GliderWinchItems/drum/docs/datasheets/Digital Stepper Driver Y Series Digital Stepper Driver_files/DM860Y%201-600x600.jpg

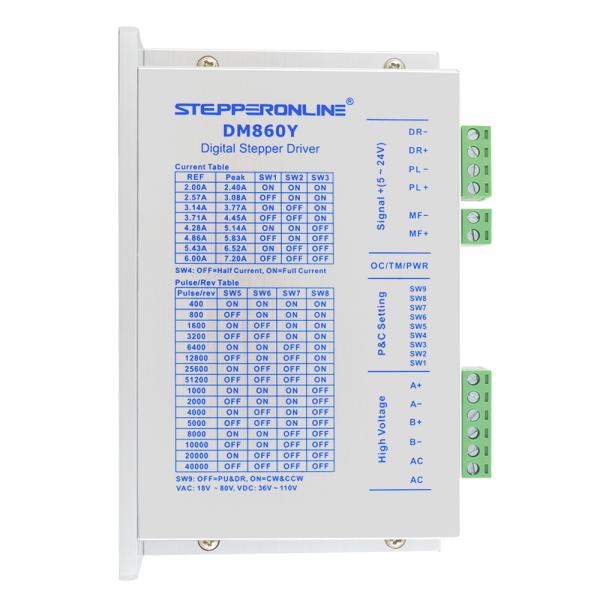
docs/datasheets/Digital Stepper Driver Y Series Digital Stepper Driver_files/DM860Y%201-600x600.jpg
