GliderWinchItems/drum/README.md

stepper

A hack of the GEVCUr repo (used for motor/dmoc testing) to test the stepper motor to be used for the winch level wind mechanism.
