GliderWinchItems/drum/drum.pdf

21/02/2025

drum Project
Configuration Report

## 1. Description

### 1.1. Project

Project Name | drum
Board Name | custom
Generated with: | STM32CubeMX 6.12.1
Date | 02/21/2025

### 1.2. MCU

MCU Series | STM32F4
MCU Line | STM32F407/417
MCU name | STM32F407VGTx
MCU Package | LQFP100
MCU Pin number | 100

### 1.3. Core(s) information

Core(s) | Arm Cortex-M4

## 2. Pinout Configuration

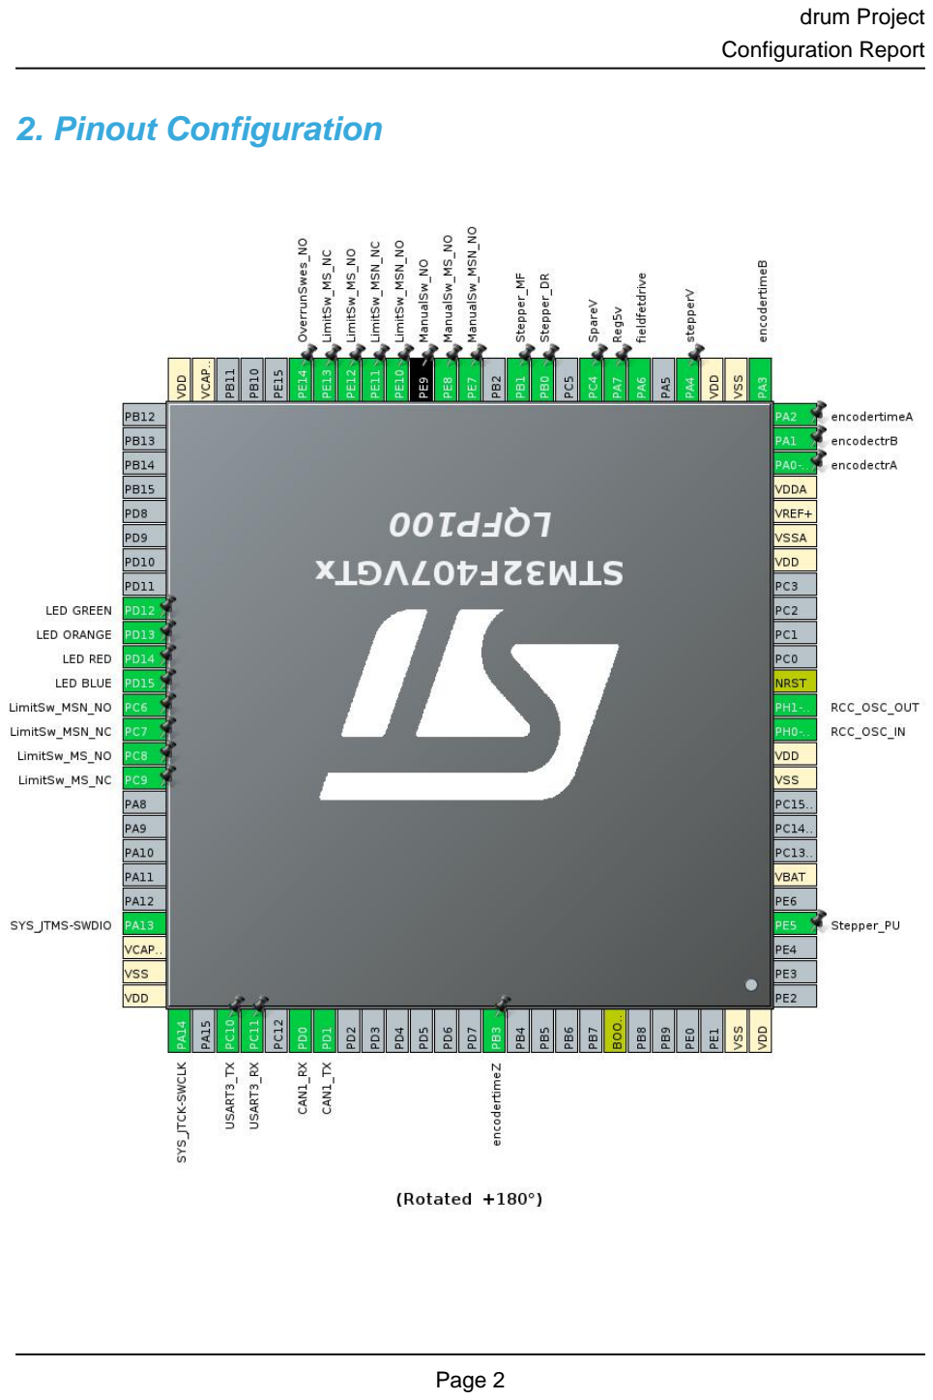
[picture p8: page 3]

## 3. Pins Configuration

Pin Number LQFP100 | Pin Name (function after reset) | Pin Type | Alternate Function(s) | Label
4 | PE5 | I/O | TIM9_CH1 | Stepper_PU
6 | VBAT | Power
10 | VSS | Power
11 | VDD | Power
12 | PH0-OSC_IN | I/O | RCC_OSC_IN
13 | PH1-OSC_OUT | I/O | RCC_OSC_OUT
14 | NRST | Reset
19 | VDD | Power
20 | VSSA | Power
21 | VREF+ | Power
22 | VDDA | Power
23 | PA0-WKUP | I/O | TIM5_CH1 | encodectrA
24 | PA1 | I/O | TIM5_CH2 | encodectrB
25 | PA2 | I/O | TIM2_CH3 | encodertimeA
26 | PA3 | I/O | TIM2_CH4 | encodertimeB
27 | VSS | Power
28 | VDD | Power
29 | PA4 | I/O | ADC1_IN4 | stepperV
31 | PA6 | I/O | TIM13_CH1 | fieldfetdrive
32 | PA7 | I/O | ADC1_IN7 | Reg5v
33 | PC4 | I/O | ADC1_IN14 | SpareV
35 | PB0 * | I/O | GPIO_Output | Stepper_DR
36 | PB1 * | I/O | GPIO_Output | Stepper_MF
38 | PE7 * | I/O | GPIO_Input | ManualSw_MSN_NO
39 | PE8 * | I/O | GPIO_Input | ManualSw_MS_NO
40 | PE9 * | I/O | GPIO_Input | ManualSw_NO
41 | PE10 | I/O | GPIO_EXTI10 | LimitSw_MSN_NO
42 | PE11 | I/O | GPIO_EXTI11 | LimitSw_MSN_NC
43 | PE12 | I/O | GPIO_EXTI12 | LimitSw_MS_NO
44 | PE13 | I/O | GPIO_EXTI13 | LimitSw_MS_NC
45 | PE14 * | I/O | GPIO_Input | OverrunSwes_NO
49 | VCAP_1 | Power
50 | VDD | Power
59 | PD12 * | I/O | GPIO_Output | LED GREEN
60 | PD13 * | I/O | GPIO_Output | LED ORANGE
61 | PD14 * | I/O | GPIO_Output | LED RED

Pin Number LQFP100 | Pin Name (function after reset) | Pin Type | Alternate Function(s) | Label
62 | PD15 * | I/O | GPIO_Output | LED BLUE
63 | PC6 | I/O | TIM3_CH1 | LimitSw_MSN_NO
64 | PC7 | I/O | TIM3_CH2 | LimitSw_MSN_NC
65 | PC8 | I/O | TIM3_CH3 | LimitSw_MS_NO
66 | PC9 | I/O | TIM3_CH4 | LimitSw_MS_NC
72 | PA13 | I/O | SYS_JTMS-SWDIO
73 | VCAP_2 | Power
74 | VSS | Power
75 | VDD | Power
76 | PA14 | I/O | SYS_JTCK-SWCLK
78 | PC10 | I/O | USART3_TX
79 | PC11 | I/O | USART3_RX
81 | PD0 | I/O | CAN1_RX
82 | PD1 | I/O | CAN1_TX
89 | PB3 | I/O | TIM2_CH2 | encodertimeZ
94 | BOOT0 | Boot
99 | VSS | Power
100 | VDD | Power

* The pin is affected with an I/O function

## 4. Clock Tree Configuration

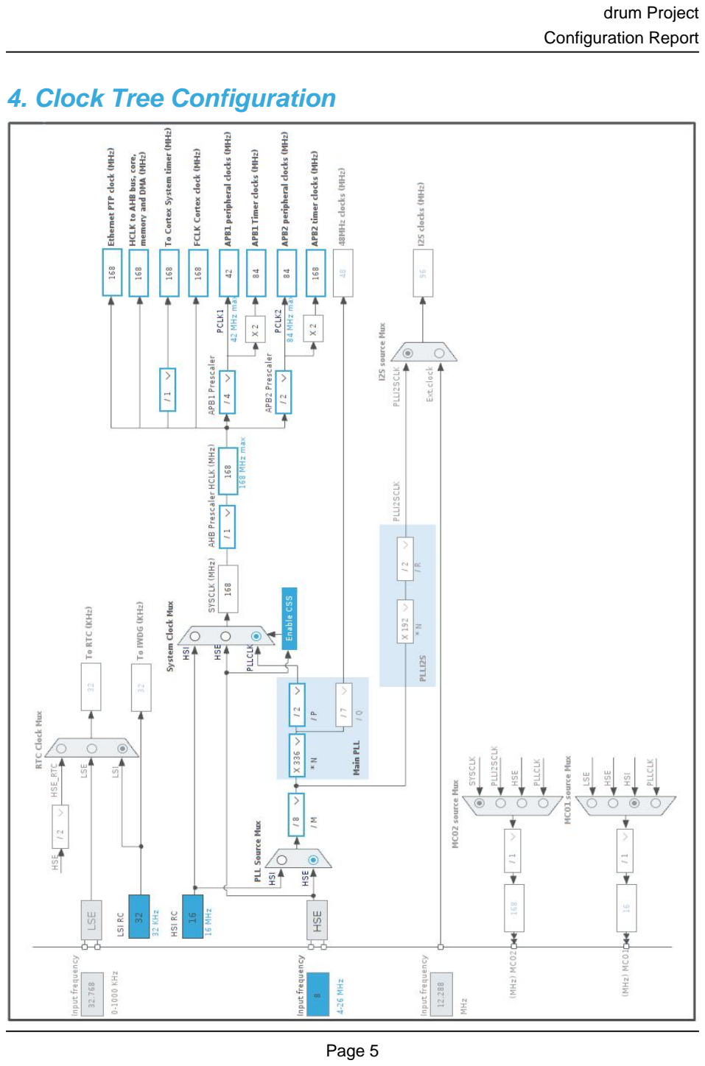
[picture p9: page 6]

## 1. Power Consumption Calculator report

### 1.1. Microcontroller Selection

Series | STM32F4
Line | STM32F407/417
MCU | STM32F407VGTx
Datasheet | DS8626_Rev8

### 1.2. Parameter Selection

Temperature | 25
Vdd | 3.3

### 1.3. Battery Selection

Battery | Li-SOCL2(A3400)
Capacity | 3400.0 mAh
Self Discharge | 0.08 %/month
Nominal Voltage | 3.6 V
Max Cont Current | 100.0 mA
Max Pulse Current | 200.0 mA
Cells in series | 1
Cells in parallel | 1

### 1.4. Sequence

Step | Step1 | Step2
Mode | RUN | STOP
Vdd | 3.3 | 3.3
Voltage Source | Battery | Battery
Range | Scale1-High | No Scale
Fetch Type | FLASH | n/a
CPU Frequency | 168 MHz | 0 Hz
Clock Configuration | HSE PLL | Regulator_LP Flash-PwrDwn
Clock Source Frequency | 4 MHz | 0 Hz
Peripherals
Additional Cons. | 0 mA | 0 mA
Average Current | 46 mA | 280 µA
Duration | 0.1 ms | 0.9 ms
DMIPS | 210.0 | 0.0
Ta Max | 98.47 | 104.96
Category | In DS Table | In DS Table

### 1.5. Results

Sequence Time | 1 ms | Average Current | 4.85 mA
Battery Life | 29 days, 4 hours | Average DMIPS | 210.0 DMIPS

### 1.6. Chart

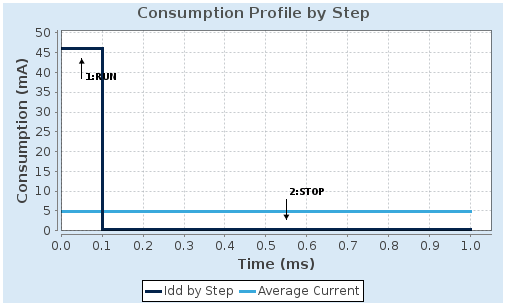
[picture p10: figure]

## 2. Software Project

### 2.1. Project Settings

Name | Value
Project Name | drum
Project Folder | /media/deh/fc65a06a-0110-42ac-85a6-
Toolchain / IDE | Makefile
Firmware Package Name and Version | STM32Cube FW_F4 V1.28.1
Application Structure | Basic
Generate Under Root | No
Do not generate the main() | No
Minimum Heap Size | 0x200
Minimum Stack Size | 0x400

### 2.2. Code Generation Settings

Name | Value
STM32Cube MCU packages and embedded software | Copy all used libraries into the project folder
Generate peripheral initialization as a pair of '.c/.h' files | No
Backup previously generated files when re-generating | No
Keep User Code when re-generating | Yes
Delete previously generated files when not re-generated | Yes
Set all free pins as analog (to optimize the power consumption) | No
Enable Full Assert | No

### 2.3. Advanced Settings - Generated Function Calls

Rank | Function Name | Peripheral Instance Name
1 | MX_GPIO_Init | GPIO
2 | MX_DMA_Init | DMA
3 | SystemClock_Config | RCC
4 | MX_CAN1_Init | CAN1
5 | MX_USART3_UART_Init | USART3
6 | MX_TIM2_Init | TIM2
7 | MX_TIM5_Init | TIM5
8 | MX_TIM9_Init | TIM9
9 | MX_TIM13_Init | TIM13
10 | MX_TIM3_Init | TIM3
11 | MX_ADC1_Init | ADC1

Rank | Function Name | Peripheral Instance Name
12 | MX_TIM4_Init | TIM4

## 3. Peripherals and Middlewares Configuration

### 3.1. ADC1

mode: IN4
mode: IN7
mode: IN14
mode: Temperature Sensor Channel mode: Vrefint Channel
3.1.1. Parameter Settings:

ADCs_Common_Settings:

Mode | Independent mode
ADC_Settings:
Clock Prescaler | PCLK2 divided by 4
Resolution | 12 bits (15 ADC Clock cycles)
Data Alignment | Right alignment
Scan Conversion Mode | Enabled
Continuous Conversion Mode | Enabled *
Discontinuous Conversion Mode | Disabled
DMA Continuous Requests | Enabled *
End Of Conversion Selection | EOC flag at the end of single channel conversion
ADC_Regular_ConversionMode:
Number Of Conversion | 5 *
External Trigger Conversion Source | Regular Conversion launched by software
External Trigger Conversion Edge | None
Rank | 1
Channel | Channel 4
Sampling Time | 480 Cycles *
Rank | 2 *
Channel | Channel 7 *
Sampling Time | 480 Cycles *
Rank | 3 *
Channel | Channel 14 *
Sampling Time | 480 Cycles *
Rank | 4 *
Channel | Channel Temperature Sensor *
Sampling Time | 480 Cycles *
Rank | 5 *

Channel | Channel Vrefint *
Sampling Time | 480 Cycles *
ADC_Injected_ConversionMode:
Number Of Conversions | 0
WatchDog:
Enable Analog WatchDog Mode | false

### 3.2. CAN1

mode: Activated
3.2.1. Parameter Settings:

Bit Timings Parameters:

Prescaler (for Time Quantum) | 12 *
Time Quantum | 285.7142857142857 *
Time Quanta in Bit Segment 1 | 5 Times *
Time Quanta in Bit Segment 2 | 1 Time
Time for one Bit | 2000 *
Baud Rate | 500000 *
ReSynchronization Jump Width | 1 Time
Basic Parameters:
Time Triggered Communication Mode | Disable
Automatic Bus-Off Management | Disable
Automatic Wake-Up Mode | Disable
Automatic Retransmission | Disable
Receive Fifo Locked Mode | Disable
Transmit Fifo Priority | Disable
Advanced Parameters:
Operating Mode | Normal

### 3.3. RCC

High Speed Clock (HSE): Crystal/Ceramic Resonator
3.3.1. Parameter Settings:

System Parameters:

VDD voltage (V) | 3.3
Instruction Cache | Enabled

Prefetch Buffer | Enabled
Data Cache | Enabled
Flash Latency(WS) | 5 WS (6 CPU cycle)
RCC Parameters:
HSI Calibration Value | 16
HSE Startup Timout Value (ms) | 100
LSE Startup Timout Value (ms) | 5000
Power Parameters:
Power Regulator Voltage Scale | Power Regulator Voltage Scale 1

### 3.4. SYS

Debug: Serial Wire
Timebase Source: TIM12

### 3.5. TIM2

Channel1: Output Compare No Output Channel2: Input Capture direct mode Channel3: Input Capture direct mode Channel4: Input Capture direct mode
3.5.1. Parameter Settings:

Counter Settings:

Prescaler (PSC - 16 bits value) | 0
Counter Mode | Up
Counter Period (AutoReload Register - 32 bits value ) | 4294967295
Internal Clock Division (CKD) | No Division
auto-reload preload | Disable
Trigger Output (TRGO) Parameters:
Master/Slave Mode (MSM bit) | Disable (Trigger input effect not delayed)
Trigger Event Selection | Reset (UG bit from TIMx_EGR)
Output Compare No Output Channel 1:
Mode | Frozen (used for Timing base)
Pulse (32 bits value) | 0
Output compare preload | Disable
CH Polarity | High
Input Capture Channel 2:
Polarity Selection | Both Edges *
IC Selection | Direct

Prescaler Division Ratio | No division
Input Filter (4 bits value) | 0
Input Capture Channel 3:
Polarity Selection | Both Edges *
IC Selection | Direct
Prescaler Division Ratio | No division
Input Filter (4 bits value) | 0
Input Capture Channel 4:
Polarity Selection | Both Edges *
IC Selection | Direct
Prescaler Division Ratio | No division
Input Filter (4 bits value) | 0

### 3.6. TIM3

Clock Source : Internal Clock Channel1: Input Capture direct mode Channel2: Input Capture direct mode Channel3: Input Capture direct mode Channel4: Input Capture direct mode
3.6.1. Parameter Settings:

Counter Settings:

Prescaler (PSC - 16 bits value) | 0
Counter Mode | Up
Counter Period (AutoReload Register - 16 bits value ) | 65535
Internal Clock Division (CKD) | No Division
auto-reload preload | Disable
Trigger Output (TRGO) Parameters:
Master/Slave Mode (MSM bit) | Disable (Trigger input effect not delayed)
Trigger Event Selection | Reset (UG bit from TIMx_EGR)
Input Capture Channel 1:
Polarity Selection | Falling Edge *
IC Selection | Direct
Prescaler Division Ratio | No division
Input Filter (4 bits value) | 15 *
Input Capture Channel 2:
Polarity Selection | Falling Edge *
IC Selection | Direct

Prescaler Division Ratio | No division
Input Filter (4 bits value) | 15 *
Input Capture Channel 3:
Polarity Selection | Falling Edge *
IC Selection | Direct
Prescaler Division Ratio | No division
Input Filter (4 bits value) | 15 *
Input Capture Channel 4:
Polarity Selection | Falling Edge *
IC Selection | Direct
Prescaler Division Ratio | No division
Input Filter (4 bits value) | 15 *

### 3.7. TIM4

Clock Source : Internal Clock Channel1: Output Compare No Output
3.7.1. Parameter Settings:

Counter Settings:

Prescaler (PSC - 16 bits value) | 13125 *
Counter Mode | Up
Counter Period (AutoReload Register - 16 bits value ) | 65535
Internal Clock Division (CKD) | No Division
auto-reload preload | Disable
Trigger Output (TRGO) Parameters:
Master/Slave Mode (MSM bit) | Disable (Trigger input effect not delayed)
Trigger Event Selection | Reset (UG bit from TIMx_EGR)
Output Compare No Output Channel 1:
Mode | Frozen (used for Timing base)
Pulse (16 bits value) | 0
Output compare preload | Disable
CH Polarity | High

### 3.8. TIM5

Combined Channels: Encoder Mode

3.8.1. Parameter Settings:

Counter Settings:

Prescaler (PSC - 16 bits value) | 0
Counter Mode | Up
Counter Period (AutoReload Register - 32 bits value ) | 4294967295
Internal Clock Division (CKD) | No Division
auto-reload preload | Disable
Trigger Output (TRGO) Parameters:
Master/Slave Mode (MSM bit) | Disable (Trigger input effect not delayed)
Trigger Event Selection | Reset (UG bit from TIMx_EGR)
Encoder:
Encoder Mode | Encoder Mode TI1
____ Parameters for Channel 1 ____
Polarity | Rising Edge
IC Selection | Direct
Prescaler Division Ratio | No division
Input Filter | 0
____ Parameters for Channel 2 ____
Polarity | Rising Edge
IC Selection | Direct
Prescaler Division Ratio | No division
Input Filter | 0

### 3.9. TIM9

mode: Clock Source
Channel1: PWM Generation CH1 mode: One Pulse Mode
3.9.1. Parameter Settings:

Counter Settings:

Prescaler (PSC - 16 bits value) | 0
Counter Mode | Up
Counter Period (AutoReload Register - 16 bits value ) | 1680 *
Internal Clock Division (CKD) | No Division
auto-reload preload | Disable
PWM Generation Channel 1:
Mode | PWM mode 1
Pulse (16 bits value) | 504 *

Output compare preload | Enable
Fast Mode | Disable
CH Polarity | High

### 3.10. TIM13

mode: Activated
Channel1: PWM Generation CH1
3.10.1. Parameter Settings:

Counter Settings:

Prescaler (PSC - 16 bits value) | 0
Counter Mode | Up
Counter Period (AutoReload Register - 16 bits value ) | 21000 *
Internal Clock Division (CKD) | No Division
auto-reload preload | Disable
PWM Generation Channel 1:
Mode | PWM mode 1
Pulse (16 bits value) | 0
Output compare preload | Enable
Fast Mode | Disable
CH Polarity | High

### 3.11. USART3

Mode: Asynchronous
3.11.1. Parameter Settings:

Basic Parameters:

Baud Rate | 115200
Word Length | 8 Bits (including Parity)
Parity | None
Stop Bits | 1
Advanced Parameters:
Data Direction | Receive and Transmit
Over Sampling | 16 Samples

### 3.12. FREERTOS

Interface: CMSIS_V1
3.12.1. Config parameters:

API:

FreeRTOS API | CMSIS v1
Versions:
FreeRTOS version | 10.3.1
CMSIS-RTOS version | 1.02
MPU/FPU:
ENABLE_MPU | Disabled
ENABLE_FPU | Disabled
Kernel settings:
USE_PREEMPTION | Enabled
CPU_CLOCK_HZ | SystemCoreClock
TICK_RATE_HZ | 512 *
MAX_PRIORITIES | 7
MINIMAL_STACK_SIZE | 96 *
MAX_TASK_NAME_LEN | 16
USE_16_BIT_TICKS | Disabled
IDLE_SHOULD_YIELD | Enabled
USE_MUTEXES | Enabled
USE_RECURSIVE_MUTEXES | Disabled
USE_COUNTING_SEMAPHORES | Disabled
QUEUE_REGISTRY_SIZE | 12 *
USE_APPLICATION_TASK_TAG | Disabled
ENABLE_BACKWARD_COMPATIBILITY | Enabled
USE_PORT_OPTIMISED_TASK_SELECTION | Enabled
USE_TICKLESS_IDLE | Disabled
USE_TASK_NOTIFICATIONS | Enabled
RECORD_STACK_HIGH_ADDRESS | Disabled
Memory management settings:
Memory Allocation | Dynamic / Static
TOTAL_HEAP_SIZE | 32768 *
Memory Management scheme | heap_4
Hook function related definitions:
USE_IDLE_HOOK | Disabled
USE_TICK_HOOK | Disabled
USE_MALLOC_FAILED_HOOK | Disabled
USE_DAEMON_TASK_STARTUP_HOOK | Disabled

CHECK_FOR_STACK_OVERFLOW | Option2 *
Run time and task stats gathering related definitions:
GENERATE_RUN_TIME_STATS | Disabled
USE_TRACE_FACILITY | Disabled
USE_STATS_FORMATTING_FUNCTIONS | Disabled
Co-routine related definitions:
USE_CO_ROUTINES | Disabled
MAX_CO_ROUTINE_PRIORITIES | 2
Software timer definitions:
USE_TIMERS | Enabled *
TIMER_TASK_PRIORITY | 2
TIMER_QUEUE_LENGTH | 10
TIMER_TASK_STACK_DEPTH | 192
Interrupt nesting behaviour configuration:
LIBRARY_LOWEST_INTERRUPT_PRIORITY | 15
LIBRARY_MAX_SYSCALL_INTERRUPT_PRIORITY | 5
Added with 10.2.1 support:
MESSAGE_BUFFER_LENGTH_TYPE | size_t
USE_POSIX_ERRNO | Disabled
3.12.2. Include parameters:

Include definitions:

vTaskPrioritySet | Enabled
uxTaskPriorityGet | Enabled
vTaskDelete | Disabled *
vTaskCleanUpResources | Disabled
vTaskSuspend | Enabled
vTaskDelayUntil | Enabled *
vTaskDelay | Enabled
xTaskGetSchedulerState | Enabled
xTaskResumeFromISR | Enabled
xQueueGetMutexHolder | Disabled
xSemaphoreGetMutexHolder | Disabled
pcTaskGetTaskName | Disabled
uxTaskGetStackHighWaterMark | Enabled *
xTaskGetCurrentTaskHandle | Enabled *
eTaskGetState | Disabled
xEventGroupSetBitFromISR | Disabled
xTimerPendFunctionCall | Disabled

xTaskAbortDelay | Disabled
xTaskGetHandle | Disabled
uxTaskGetStackHighWaterMark2 | Disabled
3.12.3. Advanced settings:

Newlib settings (see parameter description first):

USE_NEWLIB_REENTRANT | Disabled
Project settings (see parameter description first):
Use FW pack heap file | Enabled

* User modified value

## 4. System Configuration

### 4.1. GPIO configuration

IP | Pin | Signal | GPIO mode | GPIO pull/up pull down

Max
Speed

User Label

ADC1 | PA4 | ADC1_IN4 | Analog mode | No pull-up and no pull-down | n/a | stepperV
| PA7 | ADC1_IN7 | Analog mode | No pull-up and no pull-down | n/a | Reg5v
| PC4 | ADC1_IN14 | Analog mode | No pull-up and no pull-down | n/a | SpareV
CAN1 | PD0 | CAN1_RX | Alternate Function Push Pull | No pull-up and no pull-down | Very High
*
| PD1 | CAN1_TX | Alternate Function Push Pull | No pull-up and no pull-down | Very High
*
RCC | PH0- OSC_IN | RCC_OSC_IN | n/a | n/a | n/a
| PH1- OSC_OUT | RCC_OSC_OUT | n/a | n/a | n/a
SYS | PA13 | SYS_JTMS- SWDIO | n/a | n/a | n/a
| PA14 | SYS_JTCK- SWCLK | n/a | n/a | n/a
TIM2 | PA2 | TIM2_CH3 | Alternate Function
Open Drain *
| | | | No pull-up and no pull-down | Low | encodertimeA
| PA3 | TIM2_CH4 | Alternate Function
Open Drain *
| | | | No pull-up and no pull-down | Low | encodertimeB
| PB3 | TIM2_CH2 | Alternate Function
Open Drain *
| | | | No pull-up and no pull-down | Low | encodertimeZ
TIM3 | PC6 | TIM3_CH1 | Alternate Function Push Pull | Pull-up * | Low | LimitSw_MSN_NO
| PC7 | TIM3_CH2 | Alternate Function Push Pull | Pull-up * | Low | LimitSw_MSN_NC
| PC8 | TIM3_CH3 | Alternate Function Push Pull | Pull-up * | Low | LimitSw_MS_NO
| PC9 | TIM3_CH4 | Alternate Function Push Pull | Pull-up * | Low | LimitSw_MS_NC
TIM5 | PA0-WKUP | TIM5_CH1 | Alternate Function Push Pull | No pull-up and no pull-down | Low | encodectrA
| PA1 | TIM5_CH2 | Alternate Function Push Pull | No pull-up and no pull-down | Low | encodectrB
TIM9 | PE5 | TIM9_CH1 | Alternate Function Push Pull | Pull-up * | Very High
*
| | | | | | Stepper_PU
TIM13 | PA6 | TIM13_CH1 | Alternate Function Push Pull | No pull-up and no pull-down | Very High
*
| | | | | | fieldfetdrive
USART3 | PC10 | USART3_TX | Alternate Function Push Pull | No pull-up and no pull-down | Very High
*
| PC11 | USART3_RX | Alternate Function Push Pull | No pull-up and no pull-down | Very High

IP | Pin | Signal | GPIO mode | GPIO pull/up pull down | Max Speed | User Label
| | | | | *
GPIO | PB0 | GPIO_Output | Output Push Pull | No pull-up and no pull-down | Medium * | Stepper_DR
PB1 | GPIO_Output | Output Push Pull | No pull-up and no pull-down | Low | Stepper_MF
PE7 | GPIO_Input | Input mode | Pull-up * | n/a | ManualSw_MSN_NO
PE8 | GPIO_Input | Input mode | Pull-up * | n/a | ManualSw_MS_NO
PE9 | GPIO_Input | Input mode | Pull-up * | n/a | ManualSw_NO
PE10 | GPIO_EXTI10 | External Interrupt Mode with Falling edge trigger detection | Pull-up * | n/a | LimitSw_MSN_NO
PE11 | GPIO_EXTI11 | External Interrupt Mode with Falling edge trigger detection | Pull-up * | n/a | LimitSw_MSN_NC
PE12 | GPIO_EXTI12 | External Interrupt Mode with Falling edge trigger detection | Pull-up * | n/a | LimitSw_MS_NO
PE13 | GPIO_EXTI13 | External Interrupt Mode with Falling edge trigger detection | Pull-up * | n/a | LimitSw_MS_NC
PE14 | GPIO_Input | Input mode | Pull-up * | n/a | OverrunSwes_NO
PD12 | GPIO_Output | Output Push Pull | No pull-up and no pull-down | Low | LED GREEN
PD13 | GPIO_Output | Output Push Pull | No pull-up and no pull-down | Low | LED ORANGE
PD14 | GPIO_Output | Output Push Pull | No pull-up and no pull-down | Low | LED RED
PD15 | GPIO_Output | Output Push Pull | No pull-up and no pull-down | Low | LED BLUE

### 4.2. DMA configuration

DMA request | Stream | Direction | Priority
USART3_RX | DMA1_Stream1 | Peripheral To Memory | Low
USART3_TX | DMA1_Stream3 | Memory To Peripheral | Low
ADC1 | DMA2_Stream0 | Peripheral To Memory | Low

USART3_RX: DMA1_Stream1 DMA request Settings:

Mode: | Normal
Use fifo: | Disable
Peripheral Increment: | Disable
Memory Increment: | Enable *
Peripheral Data Width: | Byte
Memory Data Width: | Byte

USART3_TX: DMA1_Stream3 DMA request Settings:

Mode: | Normal
Use fifo: | Disable
Peripheral Increment: | Disable
Memory Increment: | Enable *
Peripheral Data Width: | Byte
Memory Data Width: | Byte

ADC1: DMA2_Stream0 DMA request Settings:

Mode: | Circular *
Use fifo: | Disable
Peripheral Increment: | Disable
Memory Increment: | Enable *
Peripheral Data Width: | Half Word
Memory Data Width: | Half Word

### 4.3. NVIC configuration

4.3.1. NVIC
Interrupt Table | Enable | Preenmption Priority | SubPriority
Non maskable interrupt | true | 0 | 0
Hard fault interrupt | true | 0 | 0
Memory management fault | true | 0 | 0
Pre-fetch fault, memory access fault | true | 0 | 0
Undefined instruction or illegal state | true | 0 | 0
System service call via SWI instruction | true | 0 | 0
Debug monitor | true | 0 | 0
Pendable request for system service | true | 15 | 0
System tick timer | true | 15 | 0
DMA1 stream1 global interrupt | true | 10 | 0
DMA1 stream3 global interrupt | true | 10 | 0
ADC1, ADC2 and ADC3 global interrupts | true | 7 | 0
CAN1 TX interrupts | true | 7 | 0
CAN1 RX0 interrupts | true | 7 | 0
CAN1 RX1 interrupt | true | 7 | 0
TIM1 break interrupt and TIM9 global interrupt | true | 6 | 0
TIM2 global interrupt | true | 2 | 0
TIM4 global interrupt | true | 2 | 0
USART3 global interrupt | true | 8 | 0
EXTI line[15:10] interrupts | true | 5 | 0
TIM8 break interrupt and TIM12 global interrupt | true | 0 | 0
DMA2 stream0 global interrupt | true | 7 | 0
PVD interrupt through EXTI line 16 | | unused
Flash global interrupt | | unused
RCC global interrupt | | unused
CAN1 SCE interrupt | | unused
TIM3 global interrupt | | unused
TIM8 update interrupt and TIM13 global interrupt | | unused
TIM5 global interrupt | | unused
FPU global interrupt | | unused
4.3.2. NVIC Code generation

Enabled interrupt Table Select for init
sequence ordering
| | Generate IRQ
| | handler | Call HAL handler
Non maskable interrupt | false | true | false
Hard fault interrupt | false | true | false

Enabled interrupt Table | Select for init sequence ordering | Generate IRQ handler | Call HAL handler
Memory management fault | false | true | false
Pre-fetch fault, memory access fault | false | true | false
Undefined instruction or illegal state | false | true | false
System service call via SWI instruction | false | false | false
Debug monitor | false | true | false
Pendable request for system service | false | false | false
System tick timer | false | false | true
DMA1 stream1 global interrupt | false | true | true
DMA1 stream3 global interrupt | false | true | true
ADC1, ADC2 and ADC3 global interrupts | false | true | true
CAN1 TX interrupts | false | true | true
CAN1 RX0 interrupts | false | true | true
CAN1 RX1 interrupt | false | true | true
TIM1 break interrupt and TIM9 global interrupt | false | true | true
TIM2 global interrupt | false | true | true
TIM4 global interrupt | false | true | true
USART3 global interrupt | false | true | true
EXTI line[15:10] interrupts | false | true | true
TIM8 break interrupt and TIM12 global interrupt | false | true | true
DMA2 stream0 global interrupt | false | true | true

* User modified value

## 5. System Views

5.1. Category view
5.1.1. Current

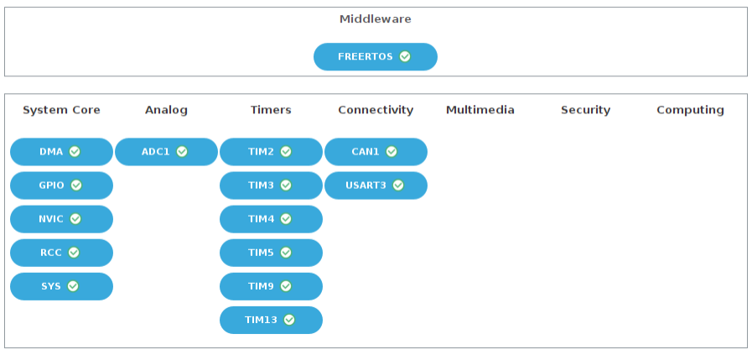
[picture p11: figure]

## 6. Docs & Resources

Type | Link
BSDL files | https://www.st.com/resource/en/bsdl_model/stm32f405-415_407-417_bsdl.zip
IBIS models | https://www.st.com/resource/en/ibis_model/stm32f405-415_407-417_ibis.zip
System View Description | https://www.st.com/resource/en/svd/stm32f4-svd.zip
Presentations | https://www.st.com/resource/en/product_presentation/stm32-stm8_embedded_software_solutions.pdf
Presentations | https://www.st.com/resource/en/product_presentation/stm32_eval-tools_portfolio.pdf
Presentations | https://www.st.com/resource/en/product_presentation/stm32_stm8_functi onal-safety-packages.pdf
Presentations | https://www.st.com/resource/en/product_presentation/stm32-stm8_software_development_tools.pdf
Presentations | https://www.st.com/resource/en/product_presentation/microcontrollers-stm32-family-overview.pdf
Presentations | https://www.st.com/resource/en/product_presentation/microcontrollers-stm32h7rs-lines-overview.pdf
Brochures | https://www.st.com/resource/en/brochure/products-and-solutions-for-plcs-and-smart-i-os.pdf
Flyers | https://www.st.com/resource/en/flyer/flstm32nucleo.pdf
Flyers | https://www.st.com/resource/en/flyer/flstmcsuite.pdf
Flyers | https://www.st.com/resource/en/flyer/flstm32trust.pdf
Product Certifications | https://www.st.com/resource/en/certification_document/stm32_authentication_can.pdf
Application Notes | https://www.st.com/resource/en/application_note/an1709-emc-design-guide-for-stm8-stm32-and-legacy-mcus-stmicroelectronics.pdf
Application Notes | https://www.st.com/resource/en/application_note/an2606-stm32-microcontroller-system-memory-boot-mode-stmicroelectronics.pdf

Application Notes | https://www.st.com/resource/en/application_note/an2639-soldering-recommendations-and-package-information-for-leadfree-ecopack-mcus-and-mpus-stmicroelectronics.pdf
Application Notes | https://www.st.com/resource/en/application_note/an2945-stm8s-and-stm32-mcus-a-consistent-832bit-product-line-for-painless-migration-stmicroelectronics.pdf
Application Notes | https://www.st.com/resource/en/application_note/an3070-managing-the-driver-enable-signal-for-rs485-and-iolink-communications-with-the-stm32s-usart-stmicroelectronics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
Application Notes | https://www.st.com/resource/en/application_note/an3126-audio-and-waveform-generation-using-the-dac-in-stm32-products-stmicroelectronics.pdf
Application Notes | https://www.st.com/resource/en/application_note/an3154-can-protocol-used-in-the-stm32-bootloader-stmicroelectronics.pdf
Application Notes | https://www.st.com/resource/en/application_note/an3155-usart-protocol-used-in-the-stm32-bootloader-stmicroelectronics.pdf
Application Notes | https://www.st.com/resource/en/application_note/an3156-usb-dfu-protocol-used-in-the-stm32-bootloader-stmicroelectronics.pdf
Application Notes | https://www.st.com/resource/en/application_note/an3364-migration-and-compatibility-guidelines-for-stm32-microcontroller-applications-stmicroelectronics.pdf
Application Notes | https://www.st.com/resource/en/application_note/an3371-using-the-hardware-realtime-clock-rtc-in-stm32-f0-f2-f3-f4-and-l1-series-of-mcus-stmicroelectronics.pdf
Application Notes | https://www.st.com/resource/en/application_note/an3997-audio-playback-and-recording-using-the-stm32f4discovery-stmicroelectronics.pdf
Application Notes | https://www.st.com/resource/en/application_note/an3998-pdm-audio-software-decoding-on-stm32-microcontrollers-stmicroelectronics.pdf
Application Notes | https://www.st.com/resource/en/application_note/an4031-using-the-stm32f2-stm32f4-and-stm32f7-series-dma-controller-stmicroelectronics.pdf
Application Notes | https://www.st.com/resource/en/application_note/an4073-how-to-improve-adc-accuracy-when-using-stm32f2xx-and-stm32f4xx-microcontrollers-stmicroelectronics.pdf

Application Notes | https://www.st.com/resource/en/application_note/an4076-two-or-three-shunt-resistor-based-current-sensing-circuit-design-in-3phase-inverters-stmicroelectronics.pdf
Application Notes | https://www.st.com/resource/en/application_note/an4221-i2c-protocol-used-in-the-stm32-bootloader-stmicroelectronics.pdf
Application Notes | https://www.st.com/resource/en/application_note/an4286-spi-protocol-used-in-the-stm32-bootloader-stmicroelectronics.pdf
Application Notes | https://www.st.com/resource/en/application_note/an4488-getting-started-with-stm32f4xxxx-mcu-hardware-development-stmicroelectronics.pdf
Application Notes | https://www.st.com/resource/en/application_note/an4547-migrating-from-stm32f407xx417xx-to-stm32f427xx429xx437xx439xx-stmicroelectronics.pdf
Application Notes | https://www.st.com/resource/en/application_note/an4566-extending-the-dac-performance-of-stm32-microcontrollers-stmicroelectronics.pdf
Application Notes | https://www.st.com/resource/en/application_note/an4640-peripherals-interconnections-on-stm32f4057xx-stm32f4157xx-stm32f42xxx-stm32f43xxx-stm32f446xx-and-stm32f469479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
Application Notes | https://www.st.com/resource/en/application_note/an4655-virtually-increasing-the-number-of-serial-communication-peripherals-in-stm32-applications-stmicroelectronics.p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
Application Notes | https://www.st.com/resource/en/application_note/an4739-stm32cube-firmware-examples-for-stm32f4-series-stmicroelectronics.pdf
Application Notes | https://www.st.com/resource/en/application_note/an4750-handling-of-soft-errors-in-stm32-applications-stmicroelectronics.pdf
Application Notes | https://www.st.com/resource/en/application_note/an4776-generalpurpose-timer-cookbook-for-stm32-microcontrollers-stmicroelectronics.pdf
Application Notes | https://www.st.com/resource/en/application_note/an4803-highspeed-si-simulations-using-ibis-and-boardlevel-simulations-using-hyperlynx-si-on-stm32-mcus-and-mpus-stmic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
Application Notes | https://www.st.com/resource/en/application_note/an4821-migrating-from-stm32f405415-line-and-stm32f407417-line-to-stm32l4-series-and-stm32l4-series-microcontrollers-s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
Application Notes | https://www.st.com/resource/en/application_note/an4850-stm32-mcus-

| spreadspectrum-clock-generation-principles-properties-and-implementation-stmicroelectronics.pdf
Application Notes | https://www.st.com/resource/en/application_note/an4989-stm32-microcontroller-debug-toolbox-stmicroelectronics.pdf
Application Notes | https://www.st.com/resource/en/application_note/an4995-using-an-electromyogram-technique-to-detect-muscle-activity-stmicroelectronics.pdf
Application Notes | https://www.st.com/resource/en/application_note/an5020-digital-camera-interface-dcmi-on-stm32-mcus-stmicroelectronics.pdf
Application Notes | https://www.st.com/resource/en/application_note/an5027-interfacing-pdm-digital-microphones-using-stm32-mcus-and-mpus-stmicroelectronics.pdf
Application Notes | https://www.st.com/resource/en/application_note/an5073-receiving-spdif-audio-stream-with-the-stm32f4f7h7-series-stmicroelectronics.pdf
Application Notes | https://www.st.com/resource/en/application_note/an4899-stm32-microcontroller-gpio-hardware-settings-and-lowpower-consumption-stmicroelectronics.pdf
Application Notes | https://www.st.com/resource/en/application_note/an5612-esd-protection-of-stm32-mcus-and-mpus-stmicroelectronics.pdf
Application Notes | https://www.st.com/resource/en/application_note/an4838-introduction-to-memory-protection-unit-management-on-stm32-mcus-stmicroelectronics.pdf
Application Notes | https://www.st.com/resource/en/application_note/an4879-introduction-to-usb-hardware-and-pcb-guidelines-using-stm32-mcus-stmicroelectronics.pdf
Application Notes | https://www.st.com/resource/en/application_note/an5225-introduction-to-usb-typec-power-delivery-for-stm32-mcus-and-mpus-stmicroelectronics.pdf
Application Notes | https://www.st.com/resource/en/application_note/an2834-how-to-optimize-the-adc-accuracy-in-the-stm32-mcus-stmicroelectronics.pdf
Application Notes | https://www.st.com/resource/en/application_note/an5537-how-to-use-adc-oversampling-techniques-to-improve-signaltonoise-ratio-on-stm32-mcus-stmicroelectronics.pdf
Application Notes | https://www.st.com/resource/en/application_note/an5036-guidelines-for-

| thermal-management-on-stm32-applications-stmicroelectronics.pdf
Application Notes | https://www.st.com/resource/en/application_note/an4230-introduction-to-random-number-generation-validation-using-the-nist-statistical-test-suite-for-stm32-mcus-and-m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
Application Notes | https://www.st.com/resource/en/application_note/an2867-guidelines-for-oscillator-design-on-stm8afals-and-stm32-mcusmpus-stmicroelectronics.pdf
Application Notes | https://www.st.com/resource/en/application_note/an4013-introduction-to-timers-for-stm32-mcus-stmicroelectronics.pdf
Application Notes | https://www.st.com/resource/en/application_note/an4277-how-to-use-pwm-shutdown-for-motor-control-and-digital-power-conversion-on-stm32-mcus-stmicroelectronics.pdf
Application Notes | https://www.st.com/resource/en/application_note/an4759-introduction-to-using-the-hardware-realtime-clock-rtc-and-the-tamper-management-unit-tamp-with-stm32-mcus-stmi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
Application Notes | https://www.st.com/resource/en/application_note/an4908-getting-started-with-usart-automatic-baud-rater-detection-for-stm32-mcus-stmicroelectronics.pdf
Application Notes | https://www.st.com/resource/en/application_note/an5156-introduction-to-security-for-stm32-mcus-stmicroelectronics.pdf
Application Notes | https://www.st.com/resource/en/application_note/an5543-guidelines-for-enhanced-spi-communication-on-stm32-mcus-and-mpus-stmicroelectronics.pdf
Application Notes for related Tools & Software | https://www.st.com/resource/en/application_note/an1202_freertos_guide-freertos-guide-stmicroelectronics.pdf
Application Notes for related Tools & Software | https://www.st.com/resource/en/application_note/an1602_semihosting_in_truestudio-how-to-do-semihosting-in-truestudio-stmicroelectronics.pdf
Application Notes for related Tools & Software | https://www.st.com/resource/en/application_note/an1801_stm32cubeprogrammer_in_truestudio-installing-stm32cubeprogrammer-in-truestudio-stmicroelectronics.pdf

Application Notes
for related Tools

https://www.st.com/resource/en/application_note/atollic_editing_keyboard_shortcuts-atollic-editing-keyboard-shortcuts-stmicroelectronics.pdf

& Software
Application Notes for related Tools & Software | https://www.st.com/resource/en/application_note/iar_to_atollic_truestudio_migration_guide-truestudio-for-arm-migration-guide-iar-embedded-workbench-to-truestudio-stm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
Application Notes for related Tools & Software | https://www.st.com/resource/en/application_note/stm32cubemx_installation_in_truestudio-stm32cubemx-installation-in-truestudio-stmicroelectronics.pdf
Application Notes for related Tools & Software | https://www.st.com/resource/en/application_note/an2656-stm32f10xxx-lcd-glass-driver-firmware-stmicroelectronics.pdf
Application Notes for related Tools & Software | https://www.st.com/resource/en/application_note/an2790-tft-lcd-interfacing-with-the-highdensity-stm32f10xxx-fsmc-stmicroelectronics.pdf
Application Notes for related Tools & Software | https://www.st.com/resource/en/application_note/an3078-stm32-inapplication-programming-over-the-ic-bus-stmicroelectronics.pdf
Application Notes for related Tools & Software | https://www.st.com/resource/en/application_note/an3116-stm32s-adc-modes-and-their-applications-stmicroelectronics.pdf
Application Notes for related Tools & Software | https://www.st.com/resource/en/application_note/an3174-implementing-receivers-for-infrared-remote-control-protocols-using-stm32f10xxx-microcontrollers-stmicroelectro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
Application Notes for related Tools & Software | https://www.st.com/resource/en/application_note/an3241-qvga-tftlcd-direct-drive-using-the-stm32f10xx-fsmc-peripheral-stmicroelectronics.pdf
Application Notes for related Tools & Software | https://www.st.com/resource/en/application_note/an3307-guidelines-for-obtaining-iec-60335-class-b-certification-for-any-stm32-application-stmicroelectronics.pdf
Application Notes for related Tools & Software | https://www.st.com/resource/en/application_note/an3364-migration-and-compatibility-guidelines-for-stm32-microcontroller-applications-stmicroelectronics.pdf
Application Notes for related Tools & Software | https://www.st.com/resource/en/application_note/an3965-stm32f40xstm32f41x-inapplication-programming-using-the-usart-stmicroelectronics.pdf

Application Notes for related Tools & Software | https://www.st.com/resource/en/application_note/an3966-lwip-tcpip-stack-demonstration-for-stm32f4x7-microcontrollers-stmicroelectronics.pdf
Application Notes for related Tools & Software | https://www.st.com/resource/en/application_note/an3968-stm32f407stm32f417-inapplication-programming-iap-over-ethernet-stmicroelectronics.pdf
Application Notes for related Tools & Software | https://www.st.com/resource/en/application_note/an3969-eeprom-emulation-in-stm32f40xstm32f41x-microcontrollers-stmicroelectronics.pdf
Application Notes for related Tools & Software | https://www.st.com/resource/en/application_note/an3988-clock-configuration-tool-for-stm32f40xx41xx427x437x-microcontrollers-stmicroelectronics.pdf
Application Notes for related Tools & Software | https://www.st.com/resource/en/application_note/an3990-upgrading-stm32f4discovery-board-firmware-using-a-usb-key-stmicroelectronics.pdf
Application Notes for related Tools & Software | https://www.st.com/resource/en/application_note/an3997-audio-playback-and-recording-using-the-stm32f4discovery-stmicroelectronics.pdf
Application Notes for related Tools & Software | https://www.st.com/resource/en/application_note/an3998-pdm-audio-software-decoding-on-stm32-microcontrollers-stmicroelectronics.pdf
Application Notes for related Tools & Software | https://www.st.com/resource/en/application_note/an4044-floating-point-unit-demonstration-on-stm32-microcontrollers-stmicroelectronics.pdf
Application Notes for related Tools & Software | https://www.st.com/resource/en/application_note/an4323-getting-started-with-stemwin-library-stmicroelectronics.pdf
Application Notes for related Tools & Software | https://www.st.com/resource/en/application_note/an4365-using-stm32f4-mcu-power-modes-with-best-dynamic-efficiency-stmicroelectronics.pdf
Application Notes for related Tools & Software | https://www.st.com/resource/en/application_note/an4435-guidelines-for-obtaining-ulcsaiec-607301603351-class-b-certification-in-any-stm32-application-stmicroelectroni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
Application Notes | https://www.st.com/resource/en/application_note/an4457-implementing-

for related Tools & Software | an-emulated-uart-on-stm32f4-microcontrollers-stmicroelectronics.pdf
Application Notes for related Tools & Software | https://www.st.com/resource/en/application_note/an4499-stm32--nrf51822-bluetooth-low-energy-system-solution-stmicroelectronics.pdf
Application Notes for related Tools & Software | https://www.st.com/resource/en/application_note/an4657-stm32-inapplication-programming-iap-using-the-usart-stmicroelectronics.pdf
Application Notes for related Tools & Software | https://www.st.com/resource/en/application_note/an4666-parallel-synchronous-transmission-using-gpio-and-dma-stmicroelectronics.pdf
Application Notes for related Tools & Software | https://www.st.com/resource/en/application_note/an4678-full-duplex-spi-emulation-for-stm32f4-microcontrollers-stmicroelectronics.pdf
Application Notes for related Tools & Software | https://www.st.com/resource/en/application_note/an4701-proprietary-code-readout-protection-on-microcontrollers-of-the-stm32f4-series-stmicroelectronics.pdf
Application Notes for related Tools & Software | https://www.st.com/resource/en/application_note/an4739-stm32cube-firmware-examples-for-stm32f4-series-stmicroelectronics.pdf
Application Notes for related Tools & Software | https://www.st.com/resource/en/application_note/an4758-proprietary-code-readout-protection-on-stm32l4-stm32l4-stm32g4-and-stm32wb-series-mcus-stmicroelectronics.pdf
Application Notes for related Tools & Software | https://www.st.com/resource/en/application_note/an4841-digital-signal-processing-for-stm32-microcontrollers-using-cmsis-stmicroelectronics.pdf
Application Notes for related Tools & Software | https://www.st.com/resource/en/application_note/an4968-proprietary-code-read-out-protection-pcrop-on-stm32f72xxx-and-stm32f73xxx-microcontrollers-stmicroelectronics.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
Application Notes for related Tools & Software | https://www.st.com/resource/en/application_note/an5056-integration-guide-for-the-xcubesbsfu-stm32cube-expansion-package-stmicroelectronics.pdf

Application Notes
for related Tools

https://www.st.com/resource/en/application_note/an5360-getting-startedwith-projects-based-on-the-stm32mp1-series-in-stm32cubeide-

& Software | stmicroelectronics.pdf
Application Notes for related Tools & Software | https://www.st.com/resource/en/application_note/an5361-getting-started-with-projects-based-on-dualcore-stm32h7-microcontrollers-in-stm32cubeide-stmicroelectronics.pd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
Application Notes for related Tools & Software | https://www.st.com/resource/en/application_note/an5394-getting-started-with-projects-based-on-the-stm32l5-series-in-stm32cubeide-stmicroelectronics.pdf
Application Notes for related Tools & Software | https://www.st.com/resource/en/application_note/an5418-how-to-build-a-simple-usbpd-sink-application-with-stm32cubemx-stmicroelectronics.pdf
Application Notes for related Tools & Software | https://www.st.com/resource/en/application_note/an5426-migrating-graphics-middleware-projects-from-stm32cubemx-540-to-stm32cubemx-550-stmicroelectronics.pdf
Application Notes for related Tools & Software | https://www.st.com/resource/en/application_note/an5464-position-control-of-a-threephase-permanent-magnet-motor-using-xcubemcsdk-or-xcubemcsdkful-stmicroelectronics.p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
Application Notes for related Tools & Software | https://www.st.com/resource/en/application_note/an5564-getting-started-with-projects-based-on-dualcore-stm32wl-microcontrollers-in-stm32cubeide-stmicroelectronics.pd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
Application Notes for related Tools & Software | https://www.st.com/resource/en/application_note/an5698-adapting-the-xcubestl-functional-safety-package-for-stm32-iec-61508-compliant-to-other-safety-standards-stmicr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
Application Notes for related Tools & Software | https://www.st.com/resource/en/application_note/an5731-stm32cubemx-and-stm32cubeide-threadsafe-solution-stmicroelectronics.pdf
Application Notes for related Tools & Software | https://www.st.com/resource/en/application_note/an4502-stm32-smbuspmbus-expansion-package-for-stm32cube-stmicroelectronics.pdf
Application Notes for related Tools & Software | https://www.st.com/resource/en/application_note/an5952-how-to-use-cmake-in-stm32cubeide-stmicroelectronics.pdf
Application Notes for related Tools & Software | https://www.st.com/resource/en/application_note/an5054-how-to-perform-secure-programming-using-stm32cubeprogrammer-stmicroelectronics.pdf

Errata Sheets | https://www.st.com/resource/en/errata_sheet/es0182-stm32f405407xx-and-stm32f415417xx-device-errata-stmicroelectronics.pdf
Datasheet | https://www.st.com/resource/en/datasheet/dm00037051.pdf
Programming Manuals | https://www.st.com/resource/en/programming_manual/pm0214-stm32-cortexm4-mcus-and-mpus-programming-manual-stmicroelectronics.pdf
Reference Manuals | https://www.st.com/resource/en/reference_manual/rm0090-stm32f405415-stm32f407417-stm32f427437-and-stm32f429439-advanced-armbased-32bit-mcus-stmicroelectronics.pdf
Technical Notes & Articles | https://www.st.com/resource/en/technical_note/tn0516-overview-of-the-stm32f0xf100xxf103xx-and-stm32f2xxf30xf4xx-mcus-pmsm-singledual-foc-sdk-v40-stmicroelectronics.p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
Technical Notes & Articles | https://www.st.com/resource/en/technical_note/tn1163-description-of-wlcsp-for-microcontrollers-and-recommendations-for-its-use-stmicroelectronics.pdf
Technical Notes & Articles | https://www.st.com/resource/en/technical_note/tn1204-tape-and-reel-shipping-media-for-stm32-microcontrollers-in-bga-packages-stmicroelectronics.pdf
Technical Notes & Articles | https://www.st.com/resource/en/technical_note/tn1205-tape-and-reel-shipping-media-for-stm8-and-stm32-microcontrollers-in-fpn-packages-stmicroelectronics.pdf
Technical Notes & Articles | https://www.st.com/resource/en/technical_note/tn1206-tape-and-reel-shipping-media-for-stm8-and-stm32-microcontrollers-in-qfp-packages-stmicroelectronics.pdf
Technical Notes & Articles | https://www.st.com/resource/en/technical_note/tn1207-tape-and-reel-shipping-media-for-stm8-and-stm32-microcontrollers-in-so-packages-stmicroelectronics.pdf
Technical Notes & Articles | https://www.st.com/resource/en/technical_note/tn1208-tape-and-reel-shipping-media-for-stm8-and-stm32-microcontrollers-in-tssop-and-ssop-packages-stmicroelectronics.p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
Technical Notes & Articles | https://www.st.com/resource/en/technical_note/tn1433-reference-device-marking-schematics-for-stm32-microcontrollers-and-microprocessors-stmicroelectronics.pdf

Technical Notes
& Articles

https://www.st.com/resource/en/technical_note/tn1489-security-bulletintn1489stpsirt-physical-attacks-on-stm32-and-stm32cube-firmware-

stmicroelectronics.pdf
