GliderWinchItems/drum/docs/datasheets/Digital Stepper Driver Y Series Digital Stepper Driver_files/34HE45-6004S%201-300x300.jpg

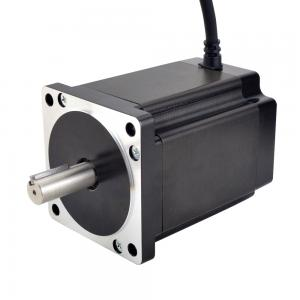
docs/datasheets/Digital Stepper Driver Y Series Digital Stepper Driver_files/34HE45-6004S%201-300x300.jpg
