GliderWinchItems/drum/docs/datasheets/Digital Stepper Driver Y Series Digital Stepper Driver_files/350w-60v-59a-115230v-switching-power-supply-stepper-motor-cn.jpg

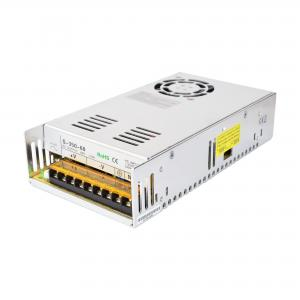
docs/datasheets/Digital Stepper Driver Y Series Digital Stepper Driver_files/350w-60v-59a-115230v-switching-power-supply-stepper-motor-cn.jpg
