GliderWinchItems/drum/Src/main.c

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
/* Includes ------------------------------------------------------------------*/
#include "main.h"
#include "cmsis_os.h"

/* USER CODE BEGIN Includes */
#include <string.h>
#include "SerialTaskSend.h"
#include "stm32f4xx_hal_pcd.h"
#include "CanTask.h"
#include "can_iface.h"
#include "canfilter_setup.h"
#include "stm32f4xx_hal_can.h"
#include "getserialbuf.h"
#include "stackwatermark.h"
#include "yprintf.h"
#include "DTW_counter.h"
#include "SerialTaskReceive.h"
#include "yscanf.h"
#include "morse.h"
#include "MailboxTask.h"

#include "levelwind_items.h"
#include "drum_items.h"
#include "LevelwindTask.h"
#include "levelwind_switches.h"
#include "DrumTask.h"
#include "BrakeTask.h"
#include "ADCTask.h"
#include "adcparams.h"
#include "tim2tim5common_init.h"
#include "OdometerTask.h"
#include "odometer_items.h"

/* USER CODE END Includes */

/* USER CODE BEGIN PTD */

void* verr[8];
uint32_t verrx = 0;
__attribute__( ( always_inline ) ) __STATIC_INLINE uint32_t __get_SP(void) 
{ 
  register uint32_t result; 

  __ASM volatile ("MOV %0, SP\n" : "=r" (result) ); 
  return(result); 
} 

uint32_t timectr = 0;
struct CAN_CTLBLOCK* pctl0;	// Pointer to CAN1 control block
struct CAN_CTLBLOCK* pctl1;	// Pointer to CAN2 control block

uint32_t debugTX1b;
uint32_t debugTX1b_prev;

uint32_t debugTX1c;
uint32_t debugTX1c_prev;

uint32_t debug03;
uint32_t debug03_prev;

extern osThreadId SerialTaskHandle;
extern osThreadId CanTxTaskHandle;
extern osThreadId CanRxTaskHandle;
extern osThreadId SerialTaskReceiveHandle;

uint16_t m_trap = 450; // Trap codes for MX Init() and Error Handler

uint8_t canflag;
uint8_t canflag1;
uint8_t canflag2;


/* USER CODE END PTD */

ADC_HandleTypeDef hadc1;
DMA_HandleTypeDef hdma_adc1;

CAN_HandleTypeDef hcan1;

TIM_HandleTypeDef htim2;
TIM_HandleTypeDef htim3;
TIM_HandleTypeDef htim4;
TIM_HandleTypeDef htim5;
TIM_HandleTypeDef htim9;
TIM_HandleTypeDef htim13;

UART_HandleTypeDef huart3;
DMA_HandleTypeDef hdma_usart3_rx;
DMA_HandleTypeDef hdma_usart3_tx;

osThreadId defaultTaskHandle;
osTimerId defaultTaskTimerHandle;
void SystemClock_Config(void);
static void MX_GPIO_Init(void);
static void MX_DMA_Init(void);
static void MX_CAN1_Init(void);
static void MX_USART3_UART_Init(void);
static void MX_TIM2_Init(void);
static void MX_TIM5_Init(void);
static void MX_TIM9_Init(void);
static void MX_TIM13_Init(void);
static void MX_TIM3_Init(void);
static void MX_ADC1_Init(void);
static void MX_TIM4_Init(void);
void StartDefaultTask(void const * argument);
void CallbackdefaultTaskTimer(void const * argument);

/**
  * @brief  The application entry point.
  * @retval int
  */
int main(void)
{

  /* USER CODE BEGIN 1 */
	BaseType_t ret;	   // Used for returns from function calls
	osMessageQId Qidret; // Function call return
	osThreadId Thrdret;  // Return from thread create

// Debug: Clear heap area
//uint32_t* pclr = (uint32_t*)(0x2000bb80);
//while (pclr < (uint32_t*)(0x2000bb80 + 32768)) *pclr++ = 0x66666666;

  /* USER CODE END 1 */

  /* MCU Configuration--------------------------------------------------------*/

  /* Reset of all peripherals, Initializes the Flash interface and the Systick. */
  HAL_Init();

  /* USER CODE BEGIN Init */
	DTW_counter_init();
  /* USER CODE END Init */

  /* Configure the system clock */
  SystemClock_Config();

  /* USER CODE BEGIN SysInit */
	
	/* Add bcb circular buffer to SerialTaskSend for usart3 -- PC monitor */
	#define NUMCIRBCB3  16 // Size of circular buffer of BCB for usart3
	ret = xSerialTaskSendAdd(&HUARTMON, NUMCIRBCB3, 1); // dma
	if (ret < 0) morse_trap(14); // Panic LED flashing

	/* Setup TX linked list for CAN  */
   // CAN1 (CAN_HandleTypeDef *phcan, uint8_t canidx, uint16_t numtx, uint16_t numrx);
	pctl0 = can_iface_init(&hcan1, 0, 32, 32);
	if (pctl0 == NULL) morse_trap(7); // Panic LED flashing
	if (pctl0->ret < 0) morse_trap(77);

	// CAN 2
#ifdef CONFIGCAN2
	pctl1 = can_iface_init(&hcan2, 1,32, 64);
	if (pctl1 == NULL) morse_trap(8); // Panic LED flashing
	if (pctl1->ret < 0) morse_trap(88);
#endif

  /* USER CODE END SysInit */

  /* Initialize all configured peripherals */
  MX_GPIO_Init();
  MX_DMA_Init();
  MX_CAN1_Init();
  MX_USART3_UART_Init();
  MX_TIM2_Init();
  MX_TIM5_Init();
  MX_TIM9_Init();
  MX_TIM13_Init();
  MX_TIM3_Init();
  MX_ADC1_Init();
  MX_TIM4_Init();
  /* USER CODE BEGIN 2 */

  //  override the enabling of the EXTI10-15 bits by MX above
  EXTI->IMR &= ~0xfc00; // disable the interrupts  
  
  /* USER CODE END 2 */

  /* USER CODE BEGIN RTOS_MUTEX */
  /* add mutexes, ... */
  /* USER CODE END RTOS_MUTEX */

  /* USER CODE BEGIN RTOS_SEMAPHORES */
  /* add semaphores, ... */
  /* USER CODE END RTOS_SEMAPHORES */

  /* Create the timer(s) */
  /* definition and creation of defaultTaskTimer */
  osTimerDef(defaultTaskTimer, CallbackdefaultTaskTimer);
  defaultTaskTimerHandle = osTimerCreate(osTimer(defaultTaskTimer), osTimerPeriodic, NULL);

  /* USER CODE BEGIN RTOS_TIMERS */
  /* start timers, add new ones, ... */

	/* defaultTask timer for pacing defaultTask output. */
//	ret = xTimerChangePeriod( defaultTaskTimerHandle  ,pdMS_TO_TICKS(64),0);

  /* USER CODE END RTOS_TIMERS */

  /* USER CODE BEGIN RTOS_QUEUES */
  /* add queues, ... */

  /* USER CODE END RTOS_QUEUES */

  /* Create the thread(s) */
  /* definition and creation of defaultTask */
  osThreadDef(defaultTask, StartDefaultTask, osPriorityNormal, 0, 384);
  defaultTaskHandle = osThreadCreate(osThread(defaultTask), NULL);

  /* USER CODE BEGIN RTOS_THREADS */
  /* add threads, ... */
/* =================================================== */
  /* init code for USB_DEVICE */

//taskENTER_CRITICAL();
  //MX_USB_DEVICE_Init();
  //osDelay(0);
//taskEXIT_CRITICAL();


	/* Create serial task (priority) */
	// Task handle "osThreadId SerialTaskHandle" is global
	Thrdret = xSerialTaskSendCreate(osPriorityNormal);	// Create task and set Task priority
	if (Thrdret == NULL) morse_trap(225);

	/* Create serial receiving task. */
	ret = xSerialTaskReceiveCreate(osPriorityNormal);
	if (ret != pdPASS) morse_trap(224);

	/* Setup semaphore for yprint and sprintf et al. */
	yprintf_init();

  /* definition and creation of CanTxTask - CAN driver TX interface. */
  Qidret = xCanTxTaskCreate(osPriorityNormal+1, 64); // CanTask priority, Number of msgs in queue
	if (Qidret < 0) morse_trap(220); // Panic LED flashing

  /* definition and creation of CanRxTask - CAN driver RX interface. */
  /* The MailboxTask takes care of the CANRx                         */
//  Qidret = xCanRxTaskCreate(1, 32); // CanTask priority, Number of msgs in queue
//	if (Qidret < 0) morse_trap(6); // Panic LED flashing

	/* Setup CAN hardware filters to default to accept all ids. */
	HAL_StatusTypeDef Cret;
	Cret = canfilter_setup_first(0, &hcan1, 15); // CAN1
	if (Cret == HAL_ERROR) morse_trap(219);

#ifdef CONFIGCAN2
	Cret = canfilter_setup_first(0, &hcan2, 15); // CAN2
	if (Cret == HAL_ERROR) morse_trap(217);
#endif

	/* Remove "accept all" CAN msgs and add specific id & mask, or id here. */
	// See canfilter_setup.h

	/* Create MailboxTask */
	xMailboxTaskCreate(osPriorityNormal+1); // (arg) = priority

	/* Create Mailbox control block w 'take' pointer for each CAN module. */
	struct MAILBOXCANNUM* pmbxret;
	// (CAN1 control block pointer, size of circular buffer)
	pmbxret = MailboxTask_add_CANlist(pctl0, 48);
	if (pmbxret == NULL) morse_trap(215);

#ifdef CONFIGCAN2
	// (CAN2 control block pointer, size of circular buffer)
	pmbxret = MailboxTask_add_CANlist(pctl1, 48); // Use default buff size
	if (pmbxret == NULL) morse_trap(214);
#endif

  /* ADC summing, calibration, etc. */
  xADCTaskCreate(osPriorityNormal+1); // (arg) = priority

/* Levelwind (stepper) task */
  Thrdret = xLevelwindTaskCreate(osPriorityNormal+2); // (arg) = priority
  if (Thrdret == NULL) morse_trap(2161); 

  /* Odometer (line speed and line out) task. */
  Thrdret = xOdometerTaskCreate(osPriorityNormal+2); // (arg) = priority
  if (Thrdret == NULL) morse_trap(2164); 

  /* Drum task */
  Thrdret = xDrumTaskCreate(osPriorityNormal); // (arg) = priority
  if (Thrdret == NULL) morse_trap(2162); 

  /* Brake task */
  Thrdret = xBrakeTaskCreate(osPriorityNormal); // (arg) = priority
  if (Thrdret == NULL) morse_trap(2163); 

	/* Further initialization of mailboxes takes place when tasks start */

	/* Select interrupts for CAN1 */
	HAL_CAN_ActivateNotification(&hcan1, \
		CAN_IT_TX_MAILBOX_EMPTY     |  \
		CAN_IT_RX_FIFO0_MSG_PENDING |  \
		CAN_IT_RX_FIFO1_MSG_PENDING    );

	/* Select interrupts for CAN2 */
#ifdef CONFIGCAN2
	HAL_CAN_ActivateNotification(&hcan2, \
		CAN_IT_TX_MAILBOX_EMPTY     |  \
		CAN_IT_RX_FIFO0_MSG_PENDING |  \
		CAN_IT_RX_FIFO1_MSG_PENDING    );
#endif

/* =================================================== */

  /* USER CODE END RTOS_THREADS */

  /* Start scheduler */
  osKernelStart();

  /* We should never get here as control is now taken by the scheduler */

  /* Infinite loop */
  /* USER CODE BEGIN WHILE */
  while (1)
  {
    /* USER CODE END WHILE */

    /* USER CODE BEGIN 3 */
  }
  /* USER CODE END 3 */
}

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
/* USER CODE BEGIN Header_StartDefaultTask */
/**
  * @brief  Function implementing the defaultTask thread.
  * @param  argument: Not used 
  * @retval None
  */
// ################################################################################
// ######### DEFAULT TASK #########################################################
// ################################################################################
/* USER CODE END Header_StartDefaultTask */
void StartDefaultTask(void const * argument)
{
  /* USER CODE BEGIN 5 */

osDelay(0); // Debugging HardFault

/* Select code for testing/monitoring by uncommenting #defines */
//#define DISPLAYSTACKUSAGEFORTASKS // Stack usage for tasks
//#define ADCSHOW
//#define SHOWADCCOMMONCOMPUTATIONS
//#define STEPPERSHOW 1
//#define ENCODERSHOW
//#define SHOWENTIMCT // Encoder time/counts used for speed computation
//#define STATES       // Levelwind state machine states
#define SHOWENCANMSG  // CAN msgs with encoder computations

	#define DEFAULTTSKBIT00	(1 << 0)  // Task notification bit for sw timer: stackusage
	#define DEFAULTTSKBIT01	(1 << 1)  // Task notification bit for sw timer: something else

	/* A notification copies the internal notification word to this. */
	uint32_t noteval = 0;    // Receives notification word upon an API notify

	struct SERIALSENDTASKBCB* pbuf1 = getserialbuf(&HUARTMON,96);
	if (pbuf1 == NULL) morse_trap(11);

	struct SERIALSENDTASKBCB* pbuf3 = getserialbuf(&HUARTMON,96);
	if (pbuf3 == NULL) morse_trap(13);

	struct SERIALSENDTASKBCB* pbuf2 = getserialbuf(&HUARTMON,96);
	if (pbuf2 == NULL) morse_trap(12);

	struct SERIALSENDTASKBCB* pbuf4 = getserialbuf(&HUARTMON,96);	
	if (pbuf4 == NULL) morse_trap(12);

  yprintf(&pbuf4,"\n\rDRUM REPO defaultTask starts 02/20/2025 #1\n\r");

  
#ifdef DISPLAYSTACKUSAGEFORTASKS
	int ctr = 0; // Running count
	uint32_t heapsize;
	uint32_t showctr = 0;
	uint32_t t1_DSUFT; // DTW time  
	uint32_t t2_DSUFT;
#endif


HAL_GPIO_TogglePin(GPIOD,GPIO_PIN_15); // BLUE LED


#ifdef  SHOWSERIALPARALLELSTUFF
uint32_t spispctr_prev = 0;
#endif

/* Countdown timer for various display speeds. */
uint16_t slowtimectr = 0; // Approx 1/sec
uint16_t medtimectr = 0;  // Approx 8/sec

uint8_t ratepace = 0;

//osDelay(1);
	xTimerChangePeriod( defaultTaskTimerHandle  ,pdMS_TO_TICKS(16),0);

#ifdef ADCSHOW
  extern uint32_t adcsumdb[6]; // debug
  extern uint16_t* p16;
  uint32_t ctr1_prev = 0;
  uint32_t ct = 0;
#endif  

#ifdef STEPPERSHOW
  uint32_t stepctr = 1;
  uint32_t dbsws1_prev[5] = {0};
#endif  

// ===== BEGIN FOR LOOP ==============================

	for (;;)
	{
	  xTaskNotifyWait(0,0xffffffff, &noteval, portMAX_DELAY);

#ifdef STATES // Display levelwind states when any of them change
    struct LEVELWINDFUNCTION* p = &levelwindfunction; // Convenience pointer
static    uint8_t  zstate_prev;    // level-wind previous state
static    uint8_t  zisr_state_prev;// level-wind ISR state, previous
static    uint8_t  zmode_prev;          // level-wind mode (Off, Track, or Center)
static    uint8_t  zindexed_prev;       // REVISIT: indexed status MAY NOT BE NEEDED
static    uint8_t  zmc_state_prev;      // master controller state 
static    uint8_t  zmc_state_sub_prev;  // master controller sub-state
static uint8_t oto_zstates;
static char* pzhdr1 = {"\n\r1 state\n\r2 isr_state\n\r3 mode"};
static char* pzhdr2 = {"\n\r4 indexed\n\r5 mc_state\n\r6 mc_state_sub"};
static char* pzhdr3 = {"\n\r7 CCMR2\n\r8 emulation_run"};

  if (oto_zstates == 0)
  { // Print column description
    oto_zstates = 1;
    yprintf(&pbuf1,"%s",pzhdr1);
    yprintf(&pbuf2,"%s",pzhdr2);
    yprintf(&pbuf3,"%s",pzhdr3);
  }

  if ((p->state        != zstate_prev)       ||
      (p->isr_state    != zisr_state_prev)   ||
      (p->mode         != zmode_prev)        ||
      (p->indexed)     != zindexed_prev      ||
      (p->mc_state     != zmc_state_prev)    ||
      (p->mc_state_sub != zmc_state_sub_prev) )
  { // Here, some state change, so output it.
    zstate_prev        = p->state;
    zisr_state_prev    = p->isr_state;
    zmode_prev         = p->mode;
    zindexed_prev      = p->indexed;
    zmc_state_prev     = p->mc_state;
    zmc_state_sub_prev = p->mc_state_sub;
    yprintf(&pbuf4,"\n\r%02X %02X %02X %02X %02X %02X ",p->state,p->isr_state,p->mode,
         p->indexed,p->mc_state,p->mc_state_sub);
extern uint8_t dbglvlem;    
    yprintf(&pbuf3,"%04X %d",htim2.Instance->CCMR2, dbglvlem);

  #if 1
    extern uint32_t dbgCR1;
    extern uint32_t dbgCNT;
    extern uint32_t dbgCCR1;
    extern uint32_t dbgDIER;
    extern uint32_t dbgCCER;
    extern uint32_t dbgCCMR1;
    extern uint32_t dbgCCMR2;
    yprintf(&pbuf1," %04X %08X %08X %04X %04X %04X %04X",dbgCR1,dbgCNT,dbgCCR1,dbgDIER,dbgCCER,dbgCCMR1,dbgCCMR2);
  #endif    
  }

#endif    

    if ((noteval & DEFAULTTSKBIT01) != 0)
    {

#ifdef SHOWENTIMCT      
      struct ODOMETERFUNCTION* pe = &odometerfunction; // Convenience pointer

      yprintf(&pbuf1,"\n\r%7d %4d", pe->odotimct_int_diff[0].tim, pe->odotimct_int_diff[0].ct);
      yprintf(&pbuf2," %7d %4d",    pe->odotimct_int_diff[1].tim, pe->odotimct_int_diff[1].ct);
      yprintf(&pbuf3," %7d %4d",    pe->odotimct_int_diff[2].tim, pe->odotimct_int_diff[2].ct);
      yprintf(&pbuf4," %7d %4d %4d",pe->odotimct_int_diff[3].tim, pe->odotimct_int_diff[3].ct, pe->en_cnt_diff);
      yprintf(&pbuf1," %9.3f", pe->odo_speed_ave_motor);
      yprintf(&pbuf2," %9.3f", pe->accel_ave_motor);
      yprintf(&pbuf3," %9.3f", pe->en_cnt_speed);
      yprintf(&pbuf4," %9.3f", pe->en_cnt_accel_motor);

#endif

#ifdef SHOWENCANMSG   
      static uint8_t oto_showcanmsg;
      if (oto_showcanmsg == 0)  
      {
        oto_showcanmsg = 1;
        yprintf(&pbuf3,"\n\rCOLUMNS\n\r1 en_cnt\n\r2 en_cnt_speed\n\r3 en_cnt_accel_motor");
        yprintf(&pbuf2,"\n\r4 odo_speed_ave_motor\n\r5 accel_ave_motor\n\r6 line_out");
      }
      struct ODOMETERFUNCTION* pe = &odometerfunction; // Convenience pointer

      yprintf(&pbuf4,"\n\r%7d", pe->en_cnt);
      yprintf(&pbuf1," %9.3f", pe->en_cnt_speed);
      yprintf(&pbuf2," %9.3f", pe->en_cnt_accel_motor);
      yprintf(&pbuf3," %9.3f", pe->odo_speed_ave_motor);
      yprintf(&pbuf4," %9.3f", pe->accel_ave_motor);
      yprintf(&pbuf1," %9.3f", pe->line_out);
#endif

    }

		if ((noteval & DEFAULTTSKBIT00) != 0)
		{

// ================= Highest rate =======================================
  
    ratepace += 1;
    if (ratepace > 32) // Slow down LCD output rate if desired
    {
      ratepace = 0; 

  #ifdef STEPPERSHOW

    #if (STEPPERSHOW == 1)
    //  print number of switch interrupts since last print 
      extern uint32_t dbsws1[5]; // Debug
 //     struct LEVELWINDFUNCTION* p = &levelwindfunction; // Convenience pointer
      stepctr++;
      if ((dbsws1[0]-dbsws1_prev[0]) != 0)
      {
          yprintf(&pbuf4,"\n\r%7i  %7i  %7i  %7i  %7i  %7i",
            stepctr,
            dbsws1[0]-dbsws1_prev[0],
            dbsws1[1]-dbsws1_prev[1],
            dbsws1[2]-dbsws1_prev[2],
            dbsws1[3]-dbsws1_prev[3],
            dbsws1[4]-dbsws1_prev[4]);
          dbsws1_prev[0] = dbsws1[0];
          dbsws1_prev[1] = dbsws1[1];
          dbsws1_prev[2] = dbsws1[2];
          dbsws1_prev[3] = dbsws1[3];
          dbsws1_prev[4] = dbsws1[4];
      }

    #elif (STEPPERSHOW == 2)
      //  print data for limit switch activation point statistics capture
      //  needs modification in levelwind_switches
      struct LEVELWINDFUNCTION* p = &levelwindfunction; // Convenience pointer
      if (p->sw[LIMITDBMS].flag1  == 1)
      {
        p->sw[LIMITDBMS].flag1  = 0;  //reset MS flag
        yprintf(&pbuf4,"\n\r  %5i %10i %10i %10i %10i",
          p->sw[LIMITDBMS].flag2,
          p->sw[LIMITDBMS].posaccum_NO,
          p->sw[LIMITDBMS].posaccum_NC,
          p->sw[LIMITDBMSN].posaccum_NO,
          p->sw[LIMITDBMSN].posaccum_NC);
      }

    #elif (STEPPERSHOW == 3)
      //  print encoder and velocity and postion accumulator data
      //  LEVELWINDDEBUG must be set to 1
      struct LEVELWINDDBGBUF* pdbg;
      struct SERIALSENDTASKBCB** ppbuf;
      do
      {
        pdbg = levelwind_items_getdbg();
        if (pdbg != NULL)
        {
          // Alternated buffers to overlap 'printf with uart output      
          if ((stepctr & 1) == 0)
            ppbuf = &pbuf4;
          else
            ppbuf = &pbuf3;

          yprintf(ppbuf,"\n\r%7u %7i %7i %7i %7i %7i %4i",
          stepctr++, 
          pdbg->intcntr,
          pdbg->tim5cnt,
          pdbg->dbg1,
          pdbg->dbg2,
          pdbg->dbg3,
          levelwindfunction.dtwmax);
        }
      } while (pdbg != NULL);
    #else
          yprintf(&pbuf4,"\n\r%9i LEVELWINDDEBUG: No debugging buffer %4i",stepctr++,levelwindfunction.dtwmax);
    #endif     

#endif      
    }

	
// ================== SLOW ==============================================
/* Countdown timer notifications. */
			slowtimectr += 1;
//			if (slowtimectr >= 16)
      if (slowtimectr >= 128)        
			{
				slowtimectr = 0;

#ifdef ADCSHOW

  yprintf(&pbuf4,"\n\r%4i %9i %6i %6i %6i %6i %6i",ct, adc1.ctr-ctr1_prev, 
    *(p16+0),*(p16+1),*(p16+2),*(p16+3),*(p16+4) );

    yprintf(&pbuf4,"\n\r%4i %9i %6i %6i %6i %6i %6i",ct++, adc1.ctr-ctr1_prev, 
    *(p16+5),*(p16+6),*(p16+7),*(p16+8),*(p16+9) );

//    adcsumdb[0],adcsumdb[1],adcsumdb[2],adcsumdb[3],adcsumdb[4]);
  ctr1_prev = adc1.ctr;
#endif      


#ifdef DISPLAYSTACKUSAGEFORTASKS
			/* Display the amount of unused stack space for tasks. */
t1_DSUFT = DTWTIME;
			showctr += 1; 
/* 'for' is to test doing all scans at one timer tick. */
for (showctr = 0; showctr < 11; showctr++)
{
				switch (showctr)
				{
/* Cycle through the tasks. */
case  0: stackwatermark_show(defaultTaskHandle,  &pbuf1,"defaultTask--");break;
case  1: stackwatermark_show(SerialTaskHandle ,  &pbuf2,"SerialTask---");break;
case  2: stackwatermark_show(CanTxTaskHandle  ,  &pbuf3,"CanTxTask----");break;
case  3: stackwatermark_show(MailboxTaskHandle,  &pbuf4,"MailboxTask--");break;
case  4: stackwatermark_show(SerialTaskReceiveHandle,&pbuf1,"SerialRcvTask");break;
case  5: stackwatermark_show(LevelwindTaskHandle,&pbuf2,"LevelwindTask");break;
case  6: stackwatermark_show(DrumTaskHandle,     &pbuf3,"DrumTask-----");break;
case  7: stackwatermark_show(BrakeTaskHandle,    &pbuf3,"BrakeTask----");break;
case  8: stackwatermark_show(ADCTaskHandle,      &pbuf4,"ADCTask------");break;
case  9: stackwatermark_show(OdometerTaskHandle, &pbuf4,"OdometerTask-");break;
case 10:	heapsize = xPortGetFreeHeapSize(); // Heap usage (and test fp working.
			yprintf(&pbuf1,"\n\rGetFreeHeapSize: total: %i free %i %3.1f%% used: %i",configTOTAL_HEAP_SIZE, heapsize,\
				100.0*(float)heapsize/configTOTAL_HEAP_SIZE,(configTOTAL_HEAP_SIZE-heapsize)); break;
default: showctr=0; yprintf(&pbuf1,"\n\r%4i Unused Task stack space--", ctr++); break;
				}
}
t2_DSUFT = DTWTIME;
yprintf(&pbuf2,"\n\rDTW DUR: %d",t2_DSUFT - t1_DSUFT);

#endif

#ifdef SHOWADCCOMMONCOMPUTATIONS
      yprintf(&pbuf4,"\n\rADC: Vdd: %7.4f %8.4f   Temp: %6.1f %6.1f",adcommon.fvdd,adcommon.fvddfilt,adcommon.degC,adcommon.degCfilt);
      yprintf(&pbuf3,"\n\rInternal ref:   %d %d",adc1.chan[ADC1IDX_INTERNALVREF].sum/ADC1DMANUMSEQ, adcommon.ivdd);
      yprintf(&pbuf2,"\n\rCalibrated: vref: %6.4f",adc1.common.fvref);
#endif

  			}
// ================= Moderate ===================================
/* Countdown timer notifications. */
			medtimectr += 1;
			if (medtimectr >= 8)
			{
				medtimectr = 0;
    		HAL_GPIO_TogglePin(GPIOD,GPIO_PIN_15); // BLUE LED
			}	
	  }
	}
  /* USER CODE END 5 */
}

/* CallbackdefaultTaskTimer function */
void CallbackdefaultTaskTimer(void const * argument)
{
  /* USER CODE BEGIN CallbackdefaultTaskTimer */
	BaseType_t xHigherPriorityTaskWoken = pdFALSE;
	if (defaultTaskHandle != NULL)
	{
		xTaskNotifyFromISR(defaultTaskHandle, 
			DEFAULTTSKBIT00,	/* 'or' bit assigned to buffer to notification value. */
			eSetBits,      /* Set 'or' option */
			&xHigherPriorityTaskWoken ); 
	}

  /* USER CODE END CallbackdefaultTaskTimer */
}

/**
  * @brief  Period elapsed callback in non blocking mode
  * @note   This function is called  when TIM12 interrupt took place, inside
  * HAL_TIM_IRQHandler(). It makes a direct call to HAL_IncTick() to increment
  * a global variable "uwTick" used as application time base.
  * @param  htim : TIM handle
  * @retval None
  */
void HAL_TIM_PeriodElapsedCallback(TIM_HandleTypeDef *htim)
{
  if (htim->Instance == TIM12) {
    HAL_IncTick();
  }
}

/**
  * @brief  This function is executed in case of error occurrence.
  * @retval None
  */
void Error_Handler(void)
{
  /* USER CODE BEGIN Error_Handler_Debug */
  /* User can add his own implementation to report the HAL error return state */
	morse_trap(m_trap); // Flash error code set in earlier MX Init()'s

  /* USER CODE END Error_Handler_Debug */
}

#ifdef  USE_FULL_ASSERT
/**
  * @brief  Reports the name of the source file and the source line number
  *         where the assert_param error has occurred.
  * @param  file: pointer to the source file name
  * @param  line: assert_param error line source number
  * @retval None
  */
void assert_failed(uint8_t *file, uint32_t line)
{
  /* USER CODE BEGIN 6 */
  /* User can add his own implementation to report the file name and line number,
     tex: printf("Wrong parameters value: file %s on line %d\r\n", file, line) */
morse_trap(222);
  /* USER CODE END 6 */
}
#endif /* USE_FULL_ASSERT */
