GliderWinchItems/drum/drum.ioc

Mcu.UserName=STM32F407VGTx
PA0-WKUP.GPIO_Label=encodectrA
PA0-WKUP.Signal=S_TIM5_CH1
PA1.GPIO_Label=encodectrB
PA1.Signal=S_TIM5_CH2
PA13.Signal=SYS_JTMS-SWDIO
PA14.Signal=SYS_JTCK-SWCLK
PA2.GPIO_Label=encodertimeA
PA2.Signal=S_TIM2_CH3
PA3.GPIO_Label=encodertimeB
PA3.Signal=S_TIM2_CH4
PA4.GPIO_Label=stepperV
PA4.Signal=ADCx_IN4
PA6.GPIO_Label=fieldfetdrive
PA6.Signal=S_TIM13_CH1
PA7.GPIO_Label=Reg5v
PA7.Signal=ADCx_IN7
PB0.GPIO_Label=Stepper_DR
PB0.Signal=GPIO_Output
PB1.GPIO_Label=Stepper_MF
PB1.Signal=GPIO_Output
PB3.GPIO_Label=encodertimeZ
PB3.Signal=S_TIM2_CH2
PC10.Signal=USART3_TX
PC11.Signal=USART3_RX
PC4.GPIO_Label=SpareV
PC4.Signal=ADCx_IN14
PC6.GPIO_Label=LimitSw_MSN_NO
PC6.Signal=S_TIM3_CH1
PC7.GPIO_Label=LimitSw_MSN_NC
PC7.Signal=S_TIM3_CH2
PC8.GPIO_Label=LimitSw_MS_NO
PC8.Signal=S_TIM3_CH3
PC9.GPIO_Label=LimitSw_MS_NC
PC9.Signal=S_TIM3_CH4
PD0.Signal=CAN1_RX
PD1.Signal=CAN1_TX
PD12.GPIO_Label=LED GREEN
PD12.Signal=GPIO_Output
PD13.GPIO_Label=LED ORANGE
PD13.Signal=GPIO_Output
PD14.GPIO_Label=LED RED
PD14.Signal=GPIO_Output
PD15.GPIO_Label=LED BLUE
PD15.Signal=GPIO_Output
PE10.GPIO_Label=LimitSw_MSN_NO
PE10.Signal=GPXTI10
PE11.GPIO_Label=LimitSw_MSN_NC
PE11.Signal=GPXTI11
PE12.GPIO_Label=LimitSw_MS_NO
PE12.Signal=GPXTI12
PE13.GPIO_Label=LimitSw_MS_NC
PE13.Signal=GPXTI13
PE14.GPIO_Label=OverrunSwes_NO
PE14.Signal=GPIO_Input
PE5.GPIO_Label=Stepper_PU
PE5.Signal=S_TIM9_CH1
PE7.GPIO_Label=ManualSw_MSN_NO
PE7.Signal=GPIO_Input
PE8.GPIO_Label=ManualSw_MS_NO
PE8.Signal=GPIO_Input
PE9.GPIO_Label=ManualSw_NO
PE9.Signal=GPIO_Input
PH0-OSC_IN.Signal=RCC_OSC_IN
PH1-OSC_OUT.Signal=RCC_OSC_OUT
