GliderWinchItems/drum/(commit log)

2020-08-22 initial loading of stuff
    [ADC_rate.ods, CP State LEDs.sch, Control Panel High Level.sch, MC Breakout-F4 & Power.sch, MC Brekout-SPInew.sch, MC F4 Pins 012114.ods, MC F4 Pins 012114.xlsx, iir2_b.ods]
2020-08-23 rm files for cleanup
    [CP State LEDs.sch, Control Panel High Level.sch, MC Breakout-F4 & Power.sch, MC Brekout-SPInew.sch, MC F4 Pins 012114.ods, MC F4 Pins 012114.xlsx, pinusage.ods]
2020-08-26 Shameless hack to avoid Mailbox pointer problem has this producing pulses controlled by the CAN msgs from the stepper repo update100K branch
    [drum.ioc, main.c, main.h]
2020-08-26 fixed prescalaing for TIM4, inverted enable
    [drum.ioc, main.c]
2020-08-26 minor changes to led flashing and TIM9 pulse duration
2020-08-27 switch to TIM2 for TIM9 stepper pulse rate control. Long time period override needs some work.
2020-08-27 update green led flash rate
2020-08-28 quick hack to eliminate wa-wa motor sound
2020-08-30 update before switching
2020-08-30 compiles and runs, but no reversal features
    [main.c]
2020-09-02 update before switch
2020-09-03 Initial code set with reversing behavior implemented
    [main.c]
2020-09-05 Fully operational reversing screw emulation
    [main.c]
2020-09-12 save current work. Not at compile status yet
2020-09-15 separate exti isr from stepper_items
2020-09-15 some rearrangement for working on stepper_switches without affecting main.c
2020-09-17 Comit for DEH to try current code
2020-09-17 Changed TIM12 FreeRTOS timebase interrupt priority to 4. Some minor clean of tabs, spacing, and comments.
2020-09-18 Code with temporary 2-edge encoder processing fix
    [main.c]
2020-09-18 Added some debugging for gsm. encoder chanA two edge TIM2 input capture in MX
2020-09-18 intermediate code in case DEH wants to make changes
2020-09-19 update before switch token
2020-09-19 pretty solid code committed before some major changes in case I want to revert
    [main.c]
2020-09-20 Timer 2 ISR routine initial structuring to support Level-Wind state machine
2020-09-21 with skeleton of interrupt behaviors vs. level wind states but at least one bug
2020-09-22 revised main to output debug vars that are buffered in stepper_items
2020-09-25 restructuring and renaming of stepper_items to levelwind_items. Initialization for Levelwind function structred similar to GEVCUr. Not thoroughly tested. Unused .c and .h files still in directories.
2020-09-25 added BrakeTask skeleton
2020-09-26 set BrakeTask priority to 1
2020-09-26 Start of replacing stepper_switches with levelwind_sitches
2020-09-26 fixed RED led in levelwind_switches. stepper_switches renamed levelwind_switches
    [LevelwindTask.c, levelwind_items.c, levelwind_switches.c]
2020-09-26 Most name changes from stepper_ to levelwind_ complete
2020-09-27 stepper name change fix
    [levelwind_items.h, main.c]
2020-09-28 Replacing case statement code with function calls for clarity in anticipation of some complex code blocks
2020-09-28 some minor changes
    [encodercablebox.scad]
2020-10-05 update b4 token sw
    [encodercablebox.scad]
2020-10-12 suppressed some bugs involing control from CP would not work with last push
    [LevelwindTask.c, levelwind_items.c]
2020-10-15 Added PE7 PE8 for Left-Off-Right switch to MX configuration
2020-10-17 Rename of Overrun and Manual switches in MX and assoicated files
2020-10-20 Deleted stepper_switches.c/h files that had been replaced by levelwind_switches.c/h
2020-10-20 Deleted stepper_item.c/h files that had been replaced by levelwind_items.c/h
2020-10-23 ADC tasks and related added. Levelwind appears to work and not be affected, but ADC details need completion
2020-10-23 Updated MX configuration for ADC PA4, PA7, PC4 w temp and vref. Calibration not tested.
2020-10-23 Sorting out ADC operations.
2020-10-24 Commit after renaming a number of level-wind struct variables to eliminate redundency and shorten.
    [LevelwindTask.c, levelwind_items.c]
2020-10-27 Fully operational centering behavior present. Indexing demo has been replaced with centering demo. Indexing demo can be reinstated by zeroing the #if around line 89 in LevelwindTask.c
    [LevelwindTask.c, levelwind_items.c]
2020-10-28 Inside/Ouside and Left/Right based names replaced with Motorside Not and Motorside.
    [LevelwindTask.c, drum.ioc, levelwind_items.c, levelwind_switches.c, main.c, main.h]
2020-10-31 Incorporated error flag int OFF sub-state
    [LevelwindTask.c, levelwind_func_init.c]
2020-11-01 Added code to do short distance centering using abreviated accel/decel profile
    [LevelwindTask.c, levelwind_items.c]
2020-11-18 fixed cpsws1_t in LevelwindTask bug
    [LevelwindTask.c, levelwind_items.c]
2020-11-18 update current work
2020-11-19 minor fixes
    [resistor_dividers.ods]
2020-11-26 switch bounce monitoring in main.c
2020-11-28 Intermediate capture with indexing in both directions partially functioning. Old demo starts immediately now. Will be chaning MX definitions on Manual and Overrun switches now and wanted a snapshot s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
2020-11-28 Mostly major cleanup of switches to reflect only PE10:13 are now interrupt driven and those interrupts only occur on falling edges
2020-11-29 Full success oriented indexing now working. Initiate by pressing MS direction switch
2020-11-29 Added centering to demo. Demo is sequenced with Manual MS direction switch. First push, start indexing; second push (during test sweeping), stop at next end point in track mode; third push, move to c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
2020-11-29 Removed Tim1 usuage and some minor clean up. Have removed material mostly commented out. Wanted a commit with that still included. Will remove those and do a new commit shortly.
    [LevelwindTask.c, levelwind_func_init.c, levelwind_items.c]
2020-11-29 Commit with commented out code for no longer used Timer 1 removed
    [LevelwindTask.c, levelwind_func_init.c, levelwind_items.c]
2020-12-10 Some additons to add sweep cycles count to raw limit switch statistics. Code runs the full demo still.
2020-12-30 Pushing intermediate updates to allow me to switch branches
2021-02-02 Partially functioning code using new dual limit switch indexing scheme. Not working properly but a good place to commit.
    [LevelwindTask.c, levelwind_func_init.c, levelwind_idx_v_struct.h, levelwind_items.c, levelwind_items.h, main.c]
2021-02-02 First kinda working code using the new SI parameters and implementing the new indexing scheme that references the position accumulator to the center of the limit switch activation points.
2021-02-05 Some clean up and set up to look for spurious limit switch interrupts
2021-02-06 Added addtional debuging provisons to explore spurious limit switch interrupts. Also changes to MX for future use of Tim2 for limit switch filter processing were made.
2021-02-12 Revised MX for no pull-ups on switch inputs
2021-02-13 Modified switches interrupt routine to mask interrupts of no interest to hide interference induced spurious interrupts and switch bounce interrupts. Spurious triggers are still present and should be 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
    [levelwind_switches.c, main.c]
2021-02-15 Minor changes captured so Don and I are looking at the same files while chasing down a bug
    [levelwind_switches.c]
2021-02-15 Corrected switches initialization code to show current debounced switch states. Also enhanced that code to enable only switch transitions of interest and disable those not of interest.
    [levelwind_switches.c]
2021-02-16 Simplified switches processing but with prior code commented out
2021-02-16 Simplified limit switch handling with old code removed
2021-02-17 Cleaned up interrupt enabling for the EXTI_10_15 interrups
2021-02-17 Added encoder and direction parameter handling and expoited removed need to deal with some previously bipolar parameters.
2021-09-08 BrakeTask.h minor update
2025-01-15 fix MSG1 lineout computation.
    [80000000-en_idx_v_struct.c, OdometerTask.h, odometer_items.c]
2025-02-10 Maybe these changes will fix the levelwind start up problem...
    [LevelwindTask.c, OdometerTask.h, levelwind_items.c, odometer_items.c, tim2tim5common_init.c]
2025-02-11 update. looking for problem with levelwind not completing startup
    [odometer_items.c, tim2tim5common_init.c]
2025-02-16 main displays states. Trying to find why levelwind not seeing encoder after intialization
2025-02-19 Fixed TIM2 SR flag reset in odometer_items and levelwind_items
    [levelwind_items.c, odometer_items.c]
2025-02-19 experimenting to find problem with initial time delay
    [LevelwindTask.c, levelwind_items.c]
2025-03-17 fix encoder_ratio constant
