GliderWinchItems/drum/(notices)

Notices in the files:
Src/main.c:
Copyright (c) 2019 STMicroelectronics International N.V.
All rights reserved.
